superdidotwitch-jpg/esp32-mp3-player/photos/README.md

# Photos

Pictures of the real builds.

## Spider

The build in order, from loose parts to the finished case.

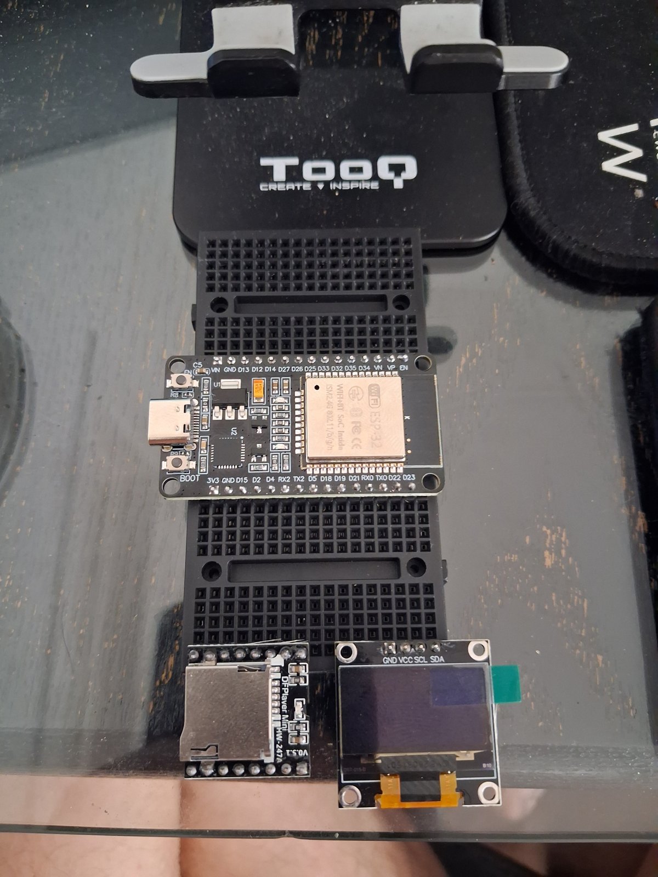
[picture p1: photos/spider-01-parts-laid-out.jpg]
The parts laid out on a breadboard


*24 September 2026.* Where it started: the ESP32 on two mini breadboards, with the DFPlayer Mini and the OLED screen below it. Nothing is wired yet.

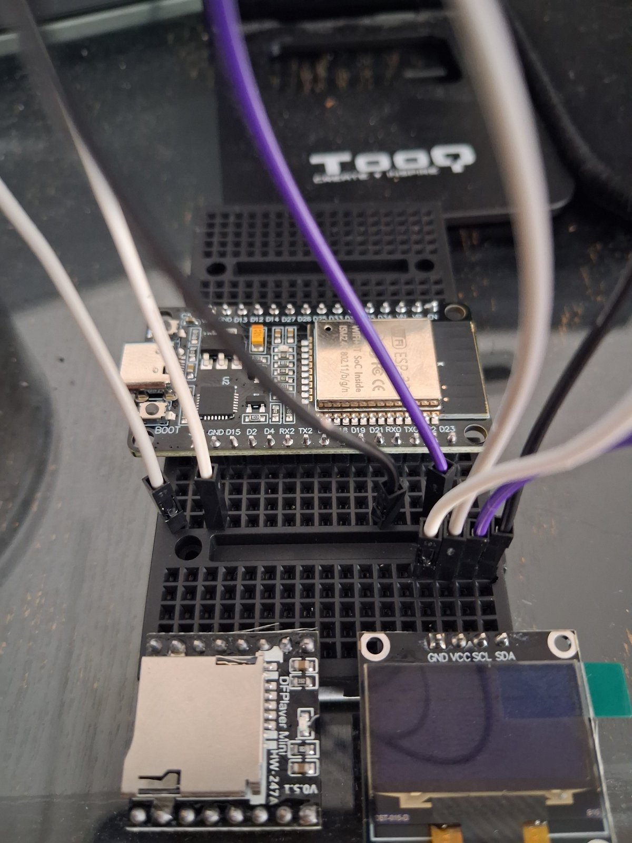
[picture p2: photos/spider-02-first-wires.jpg]
The first jumper wires in


*24 September 2026.* The first jumper wires going in for the screen and the player.

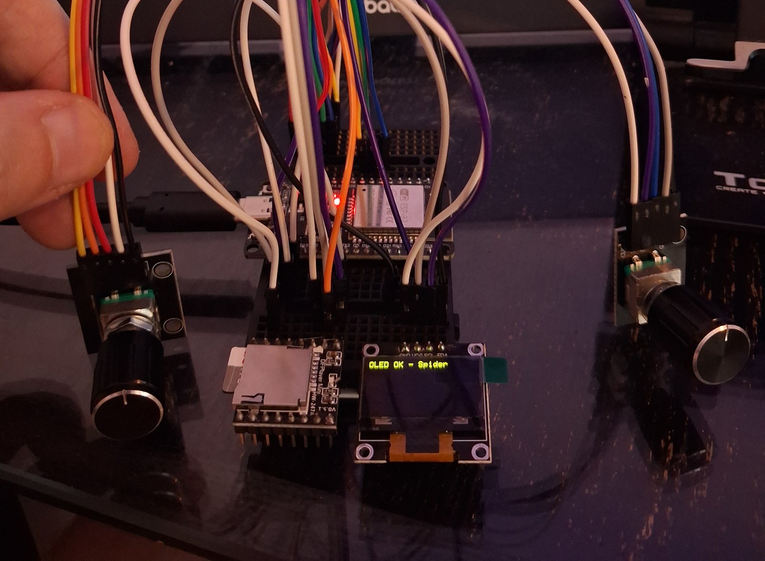
[picture p3: photos/spider-03-first-screen-test.jpg]
First screen test with both knobs connected


*24 September 2026.* The first sign of life. The screen reads "OLED OK - Spider" and both rotary encoders are connected and being tested.

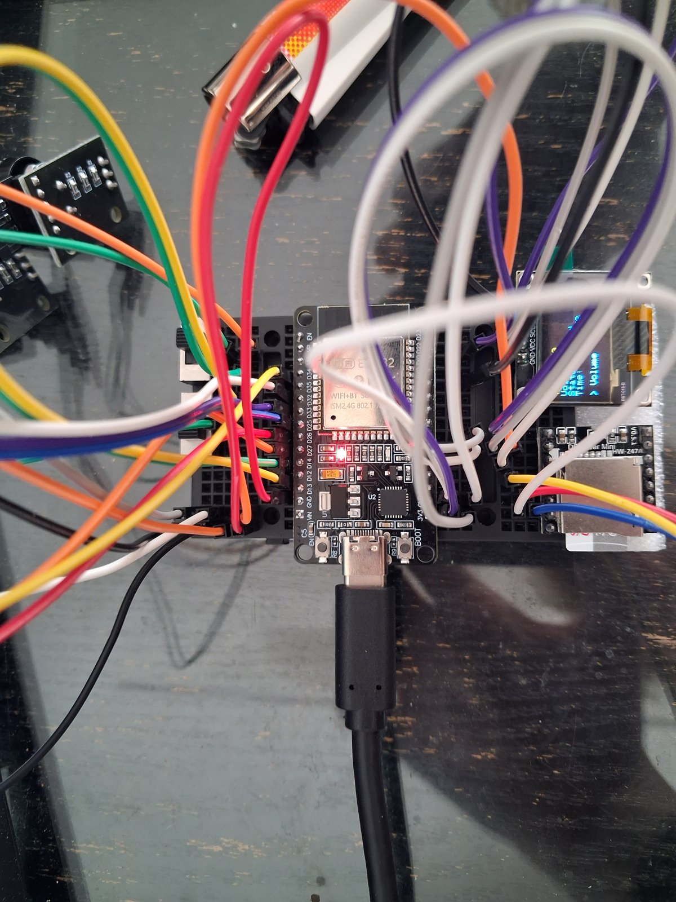
[picture p4: photos/spider-04-breadboard-from-above.jpg]
The breadboard from above with all the wiring


*25 September 2026.* The breadboard from above with everything wired: the two encoders off to the left, the screen and the player on the right, power coming in over USB-C.

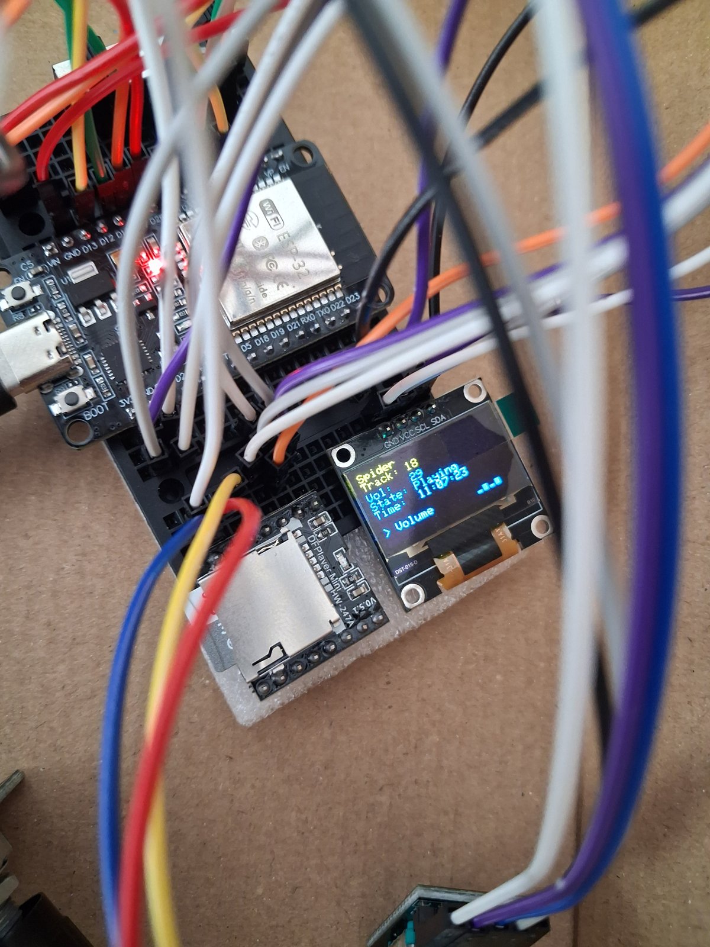
[picture p5: photos/spider-05-playing.jpg]
Spider playing a track


*1 October 2026.* Playing. The screen shows the track number, volume, state and the clock, with the small moving bars in the corner while music plays.

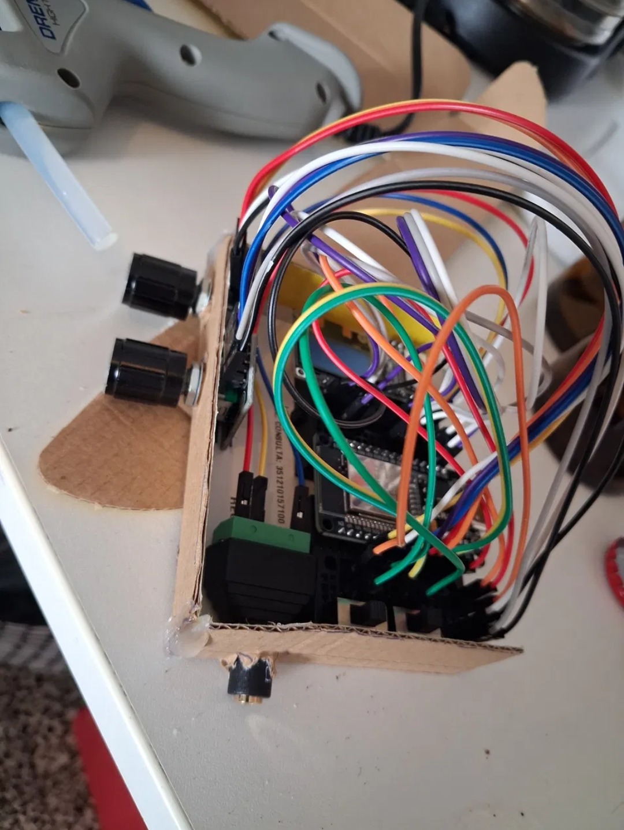
[picture p6: photos/spider-in-case.jpg]
Spider in its cardboard case


*October 2026.* Spider in its cardboard case, on the day the case was built. The two encoder knobs go through the side wall, the 3.5mm jack pokes through the front, and the ESP32 sits under the jumper wires across the two breadboards. The glue gun in the background is what holds it all together.

## Still to add

- The one-knob unit (Octopus)
- The perfboard build, when it happens
