superdidotwitch-jpg/esp32-mp3-player/(commit log)

2026-10-05 ESP32 MP3 player: parts list, wiring, firmware spec, lessons learned
2026-10-07 Add the Spider firmware (two-knob unit) with setup notes and pin table
    WiFi name and password replaced with placeholders.
    Claude-Session: https://claude.ai/code/session_01WYyeMKyZbP4SX8hkGqkzjb
    [spider.ino]
